ukagit/sdr_kiss/overview.odt

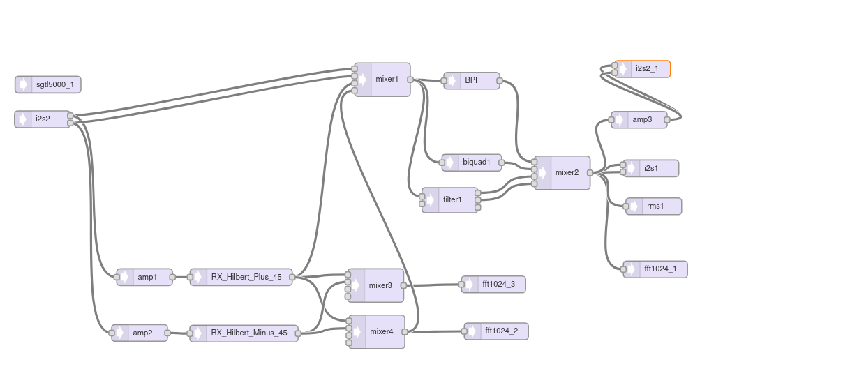
[picture p5: figure]
