ukagit/sdr_kiss/Teensy_BLOCK.png

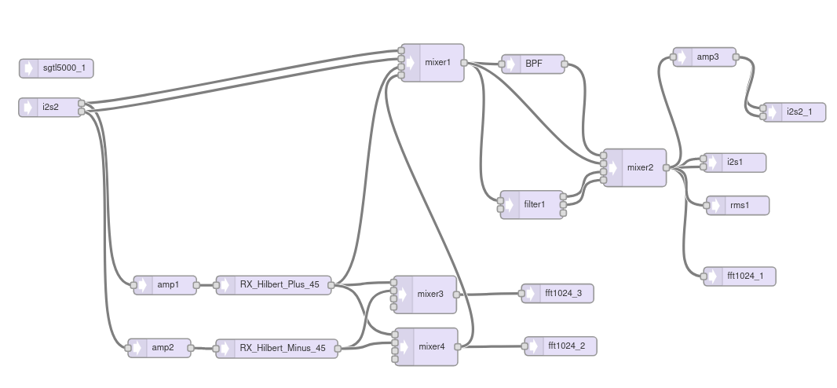
Teensy_BLOCK.png
