ukagit/sdr_kiss/(commit log)

2024-03-11 circuit_diagram include
    circuit_diagram include
2024-03-11 Update README.md
    circuit diagram
